opendous/Upconverter1v3/README.md

# Upconverter1v3
Upconverter 125MHz v1.3 - Passive Upconverter Hardware Design for SDR

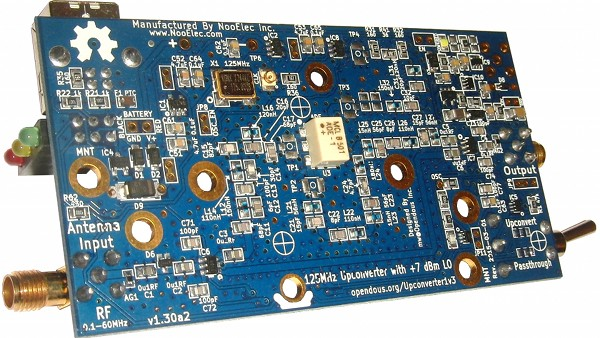
[picture p1: Upconverter-125MHz-ADE_Picture-Small.jpg]
Upconverter1v3 Picture


Converts signals in the [MF](http://en.wikipedia.org/wiki/Medium_frequency) and [HF](http://en.wikipedia.org/wiki/High_frequency) Bands (0.1MHz to 60MHz) to signals in the [VHF](https://en.wikipedia.org/wiki/Very_high_frequency) Band (125.5MHz to 175MHz). Intended for use in receiver applications with projects like [RTL-SDR](http://sdr.osmocom.org/trac/wiki/rtl-sdr). 

Available from [NooElec](http://www.nooelec.com/store/ham-it-up.html) or [eBay](http://www.ebay.com/sch/i.html?_from=R40&_nkw=Ham+It+Up+Upconverter+v1.3&_sacat=0).

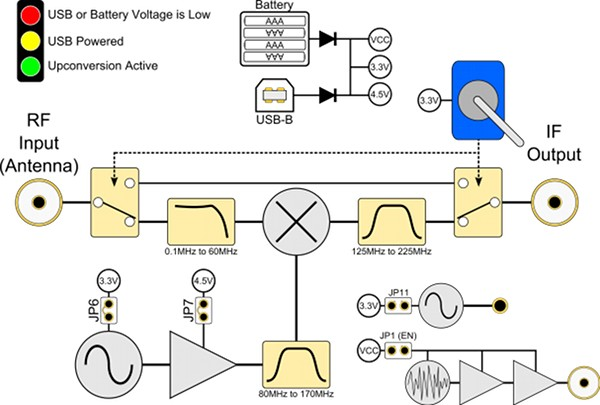
[picture p2: Upconverter_Diagram-Small.jpg]
Upconverter1v3 Diagram Diagram
