opendous/Upconverter1v3/GERBERS/readme.txt

File Format: Gerber RS-274-X
Plot Origin: Absolute

	Upconverter-125MHz-ADE-F_Paste.gtp	: Top/Front Layer Solder Paste Stencil

	Upconverter-125MHz-ADE-F_SilkS.gto	: Top/Front Layer White Silkscreen
	Upconverter-125MHz-ADE-F_Mask.gts	: Top/Front Layer Green Solder Mask
	Upconverter-125MHz-ADE-Front.gtl	: Top/Front Copper Layer
	Upconverter-125MHz-ADE-Back.gbl		: Bottom/Back Copper Layer
	Upconverter-125MHz-ADE-B_Mask.gbs	: Bottom/Back Layer Green Solder Mask

	Upconverter-125MHz-ADE-Edge_Cuts.gbr	: PCB Edge Outline

Drill File: Upconverter-125MHz-ADE.drl
	Excellon
	Units: Inches
	M.N (Precision) -> 2.4
	Mode (Drill Origin) : Absolute
	Zeros Format: Suppress Leading Zeros
	Type : ASCII
	Drill Holes (Pads and Vias): 590
	Notes:	- No axis mirroring
		- Standard Vias Only
		- All holes are plated
