opendous/Upconverter1v3/GERBERS/Upconverter-125MHz-ADE_PCB_Preview.jpg

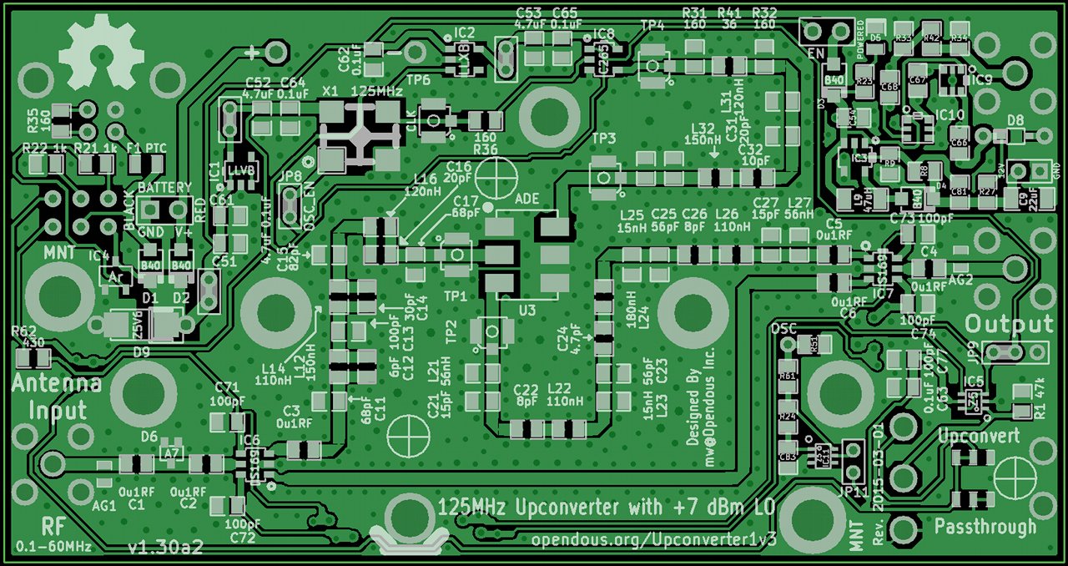
GERBERS/Upconverter-125MHz-ADE_PCB_Preview.jpg
