opendous/Upconverter1v3/Upconverter-125MHz-ADE_Layout.jpg

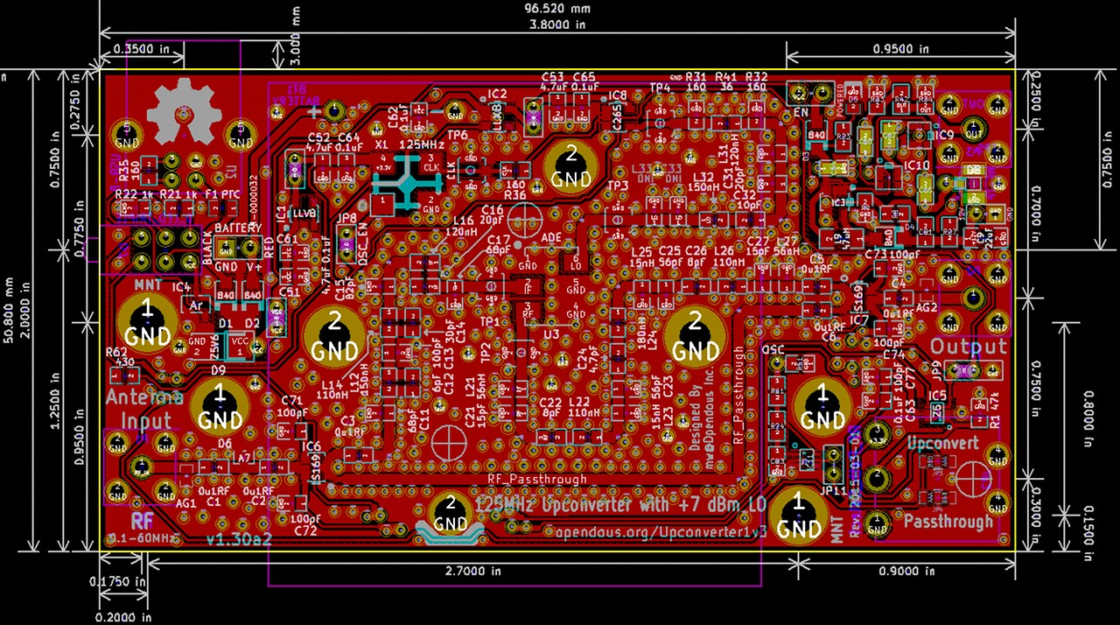
Upconverter-125MHz-ADE_Layout.jpg
