opendous/Upconverter1v3/Upconverter-125MHz-ADE_Schematic.pdf

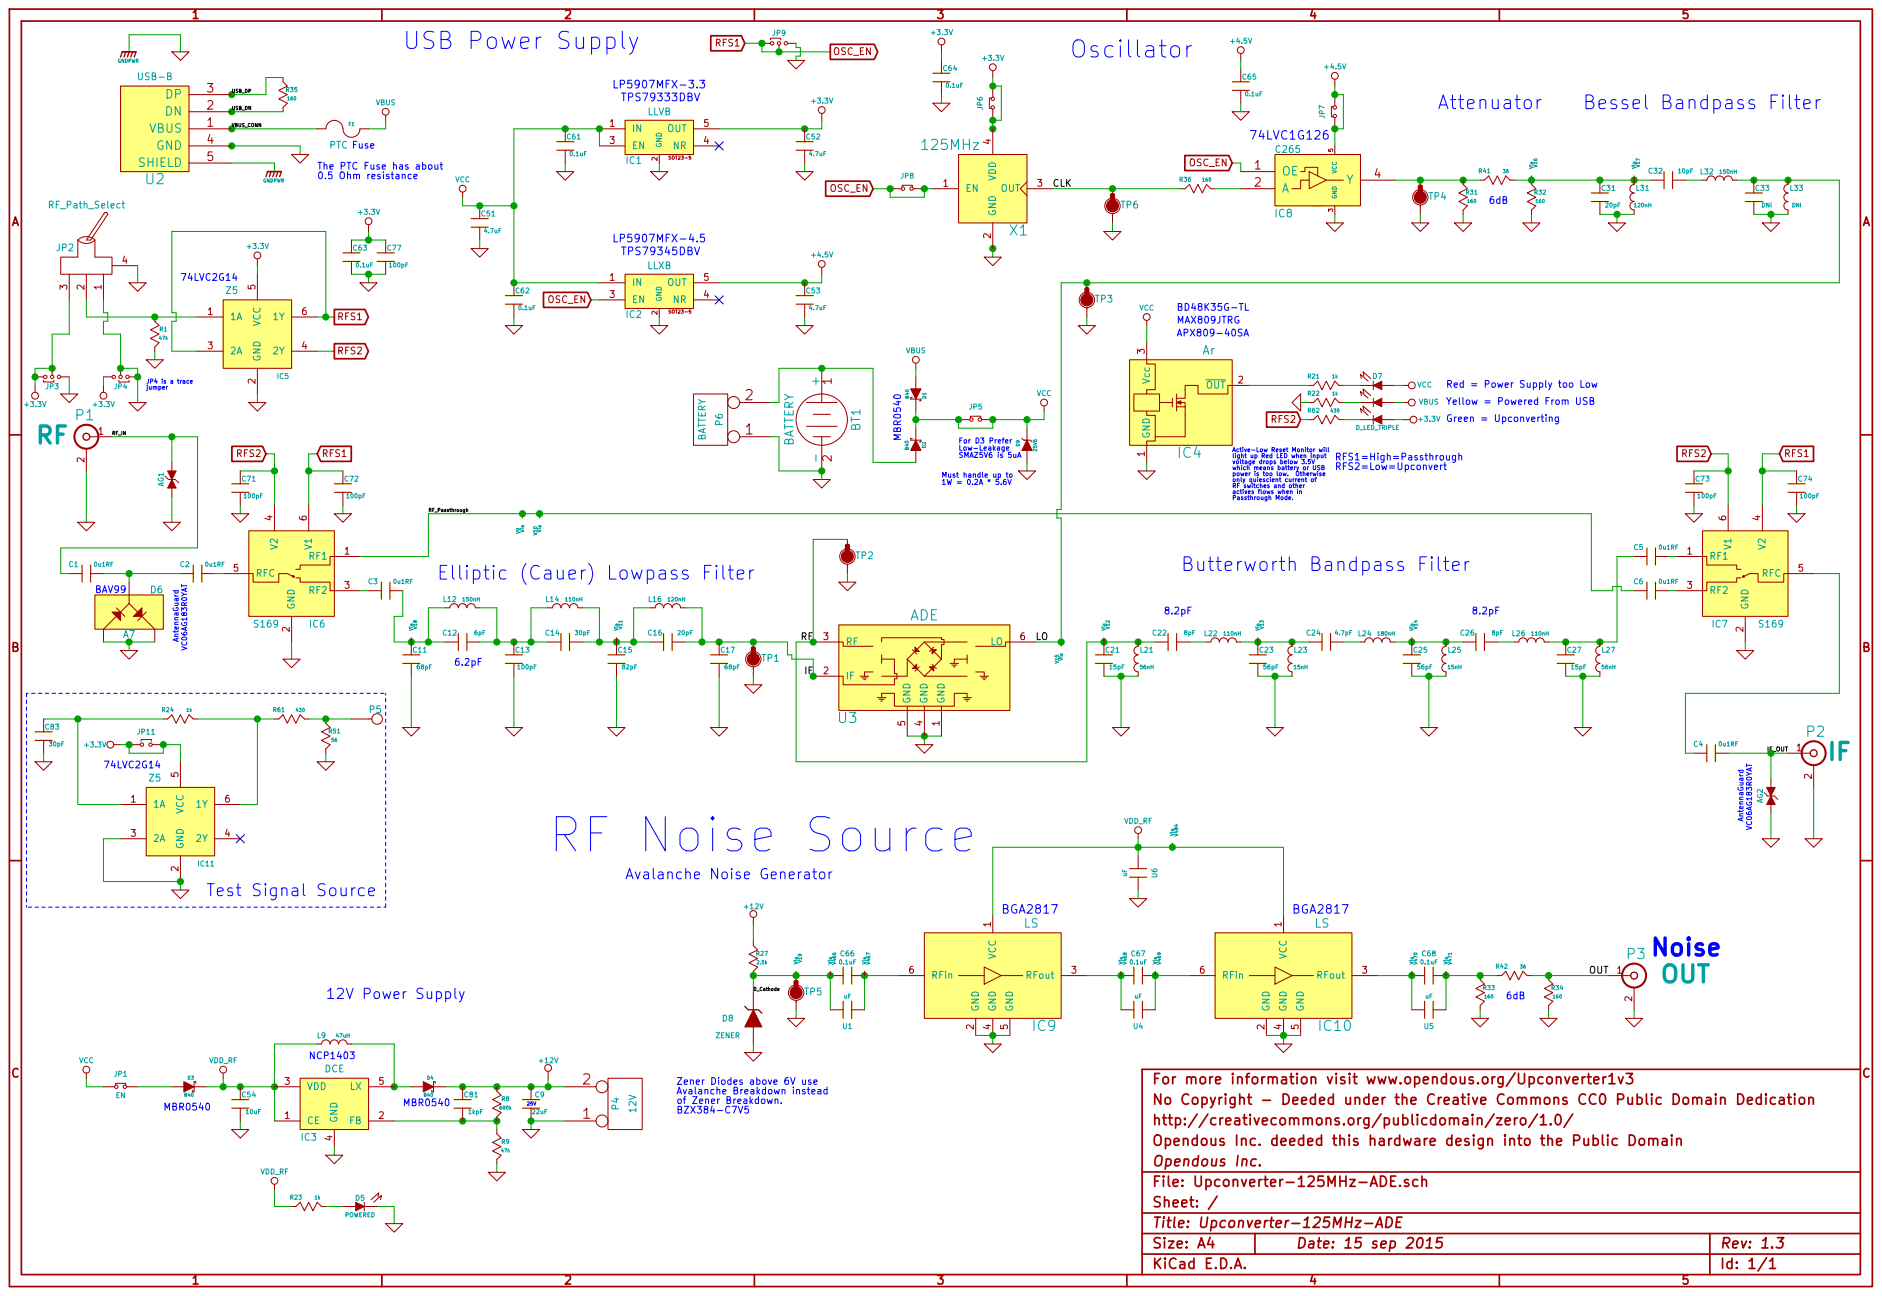
[picture p5: page 1]

Bessel Bandpass Filter RF

Yellow = Powered From USB Green = Upconverting

Active-Low Reset Monitor will
light up Red LED when input voltage drops below 3.5V which means battery or USB

power is too low. Otherwise

For more information visit www.opendous.org/Upconverter1v3
No Copyright - Deeded under the Creative Commons CC0 Public Domain Dedication
http://creativecommons.org/publicdomain/zero/1.0/
Opendous Inc. deeded this hardware design into the Public Domain
Opendous Inc.
File: Upconverter-125MHz-ADE.sch
Sheet: /
Title: Upconverter-125MHz-ADE
KiCad E.D.A.
