opendous/Upconverter1v3/Upconverter-125MHz-ADE.kicad_pcb

## KiCad design Upconverter-125MHz-ADE.kicad_pcb (2015-09-15)

Schematic: Upconverter-125MHz-ADE.sch

Parts:
AG1, AG2: ESD; 0603
BT1: BATTERY; BatteryHolder_2481_4AAA
C1, C2, C3, C4, C5, C6: 0u1RF; 0805
C9: 22uF; 1206
C11, C17: 68pF; 0805
C12: 6pF; 0805
C13, C71, C72, C73, C74, C77: 100pF; 0805
C14, C83: 30pF; 0805
C15: 82pF; 0805
C16, C31: 20pF; 0805
C21, C27: 15pF; 0805
C22, C26: 8pF; 0805
C23, C25: 56pF; 0805
C24: 4.7pF; 0805
C32: 10pF; 0805
C33: DNI; 0805
C51, C52, C53: 4.7uF; 0805
C54: 10uF; 0805
C61, C62, C63, C64, C65, C66, C67, C68: 0.1uF; 0805
C81: 1kpF; 0805
D1, D2, D3, D4: B40; SOD123
D5: POWERED; 0805
D6: A7; SC70-3_SOT-323
D7: D_LED_TRIPLE; 564-0x00_Triple_LED
D8: ZENER; SOD-323
D9: Z5V6; SMA_DO214A_Diode
F1: PTC; 0805
IC1: LLVB; SOT23-5
IC2: LLXB; SOT23-5
IC3: DCE; SOT23-5
IC4: Ar; SOT23-3
IC5: Z5; SC70-6
IC6, IC7: S169; SOT23-6
IC8: C265; SOT23-5
IC9, IC10: LS; SOT363_NXP
IC11: Z5; 000_SC70-6
JP1: EN; SIL-2
JP2: RF_Path_Select; MTS-1x2-C3
JP3, JP4: JUMPER-3; 0603_Jumper
JP5, JP6, JP7: JUMPER-2-NON; SIL-2POS-2mm
JP8: OSC_EN; SIL-2POS-2mm
JP9: JUMPER-3; SIL-3POS-2mm
JP11: JUMPER-2; SIL-2POS-2mm
L9: 47uH; 1206
L12, L32: 150nH; 0805
L14, L22, L26: 110nH; 0805
L16, L31: 120nH; 0805
L21, L27: 56nH; 0805
L23, L25: 15nH; 0805
L24: 180nH; 0805
L33: DNI; 0805
Logo1: Logo; OSHW_Logo
P1: RF; SMA_TH_RA
P2: IF; SMA_TH_RA
P3: OUT; SMA_TH_RA
P4: 12V; SIL-2POS-2mm
P5: OSC; 1Pin_32mil_VIA
P6: BATTERY; SIL-2
R1, R9: 47k; 0805
R8: 680k; 0805
R21, R22, R23, R24: 1k; 0805
R27: 2.5k; 0805
R31, R32, R33, R34, R35, R36: 160; 0805
R41, R42: 36; 0805
R51: 56; 0805
R61, R62: 430; 0805
TP1, TP2, TP3, TP4, TP5: RF-TP; UMCC_RF_PCB_RCPTCL
TP6: CLK; UMCC_RF_PCB_RCPTCL
U1, U4, U5, U6: uF; 0805
U2: USB-B; CONN_USB_B
U3: ADE; MiniCircuits_PL-052
V1, V2, V3, V4, V5, V6, V7, V8, V19, V20, V21, V22, V23, V24, V25, V26, V27, V28, V29, V30, V31, V32, V33, V34, V35, V36, V37, V38, V39, V40, V41, V42, V43, V44, V45, V46, V47, V48, V49, V50, V51, V52, V53, V54, V55, V56, V57, V58, V59, V60, V61, V62, V63, V64, V65, V66, V67, V68, V69, V70, V71, V72, V73, V74, V75, V76, V77, V78, V79, V80, V81, V82, V83, V84, V85, V86, V87, V88, V89, V90, V91, V92, V93, V94, V95, V96, V97, V98, V99, V100, V101, V102, V103, V104, V105, V106, V107, V108, V109, V110, V111, V112, V113, V114, V115, V116, V117, V118, V119, V120, V121, V122, V123, V124, V125, V126, V127, V128, V129, V130, V131, V132, V133, V134, V135, V136, V137, V138, V139, V140, V141, V142, V143, V144, V145, V146, V147, V148, V149, V150, V151, V152, V153, V154, V155, V156, V157, V158, V159, V160, V161, V162, V163, V164, V165, V166, V167, V168, V169, V170, V171, V172, V173, V174, V175, V176, V177, V178, V179, V180, V181, V182, V183, V184, V185, V186, V187, V188, V189, V190, V191, V192, V193, V194, V195, V196, V197, V198, V199, V200, V201, V202, V203, V204, V205, V206, V207, V208, V209, V210, V211, V212, V213, V214, V215, V216, V217, V218, V219, V220, V221, V222, V223, V224, V225, V226, V227, V228, V229, V230, V231, V232, V233, V234, V235, V236, V237, V238, V239, V240, V241, V242, V243, V244, V245, V246, V247, V248, V249, V250, V253, V254, V257, V258, V259, V260, V261, V262, V263, V264, V265, V266, V267, V268, V269, V270, V271, V272, V273, V274, V275, V276, V277, V278, V279, V280, V281, V282, V283, V284, V285, V286, V287, V288, V289, V290, V291, V292, V293, V294, V295, V296, V297, V298, V299, V300, V301, V302, V303, V304, V305, V306, V307, V308, V309, V310, V311, V312, V313, V314, V315, V316, V317, V318, V319, V320, V321, V322, V323, V324, V325, V326, V327, V328, V329, V330, V331, V332, V333, V334, V335, V336, V337, V338, V339, V340, V341, V342, V343, V344, V345, V346, V347, V348, V349, V350, V351, V352, V353, V354, V355, V356, V357, V358, V359, V360, V361, V362, V363, V364, V365, V366, V367, V368, V369, V370, V371, V372, V373, V374, V375, V376, V377, V458, V459, V460, V461, V462, V463, V464, V465, V466, V467, V468, V469, V470, V471, V472, V473, V474, V475, V476, V477, V478, V479, V480, V481, V482, V483, V484, V485, V493, V494, V497, V498, V513, V514, V515, V516, V517, V518, V519, V520, V521, V522, V523, V524: VIA; 1Pin_20mil_VIA
V9, V10, V11, V12, V13, V14, V15, V16, V17, V18: VIA; RF_Mitered_Corner_44mil
V251, V252, V255, V256, V378, V379, V380, V381, V382, V383, V384, V385, V386, V387, V388, V389, V390, V391, V392, V393, V394, V395, V396, V397, V398, V399, V400, V401, V402, V403, V404, V405, V406, V407, V408, V409, V410, V411, V412, V413, V414, V415, V416, V417, V418, V419, V420, V421, V422, V423, V424, V425, V426, V427, V428, V429, V430, V431, V432, V433, V434, V435, V436, V437, V438, V439, V440, V441, V442, V443, V444, V445, V446, V447, V448, V449, V450, V451, V452, V453, V454, V455, V456, V457, V486, V487, V488, V489, V490, V491, V492, V495, V496, V499, V500, V525, V526, V527, V528, V529, V530, V531, V532, V533, V534, V535, V536, V537, V538, V539, V540: VIA; 1Pin_25mil_VIA
V501, V502, V503, V504, V505, V506, V507, V508, V509, V510, V511, V512: VIA; 1Pin_32mil_VIA
X1: 125MHz; Crystal_7x5mm

Connections:
+3.3V: C52.1 (A), C63.1 (A), C64.1 (A), C77.1 (A), D7.6, IC1.5 (OUT), IC5.5 (VCC), IC11.5 (VCC), JP2.3 (B), JP3.2, JP3.3, JP4.1, JP6.1, JP6.2, JP11.1, JP11.2, V253.1, V254.1, V255.1, V256.1, X1.4 (VDD)
+4.5V: C53.1 (A), C65.1 (A), IC2.5 (OUT), IC8.5, JP7.1, JP7.2
+12V: C9.1 (A), C81.1 (A), D4.1, P4.2 (PM), R8.2 (B), R27.2 (B)
/CLK: R36.2 (B), TP6.1 (RF), X1.3 (OUT)
/D_Cathode: C66.1 (A), D8.1, R27.1 (A), TP5.1 (RF), U1.1 (A), V19.1, V466.1
/IF: C16.2 (B), C17.1 (A), L16.1 (A), TP1.1 (RF), U3.2 (IF)
/IF_OUT: AG2.1, C4.2 (B), P2.1 (In)
/LO: C33.1 (A), L32.1 (A), L33.1 (A), TP3.1 (RF), U3.6 (LO), V15.1
/OUT: P3.1 (In), R34.2 (B), R42.1 (A)
/RF: C21.1 (A), C22.1 (A), L21.1 (A), TP2.1 (RF), U3.3 (RF), V12.1
/RF_IN: AG1.1, C1.1 (A), P1.1 (In)
/RF_Passthrough: C6.1 (A), IC6.1 (RF1), V9.1, V10.1
/USB_DN: R35.1 (A), U2.2 (DN)
/USB_DP: R35.2 (B), U2.3 (DP)
/VBUS_CONN: F1.2 (B), U2.1 (VBUS)
GND: AG1.2, AG2.2, BT1.2 (-), C9.2 (B), C11.2 (B), C13.2 (B), C15.2 (B), C17.2 (B), C21.2 (B), C23.2 (B), C25.2 (B), C27.2 (B), C31.2 (B), C33.2 (B), C51.2 (B), C52.2 (B), C53.2 (B), C54.2 (B), C61.2 (B), C62.2 (B), C63.2 (B), C64.2 (B), C65.2 (B), C71.2 (B), C72.2 (B), C73.2 (B), C74.2 (B), C77.2 (B), C83.2 (B), D5.1 (K), D6.1, D6.2, D8.2, D9.2, IC1.2 (GND), IC2.2 (GND), IC3.4, IC4.1 (GND), IC5.2 (GND), IC6.2 (GND), IC7.2 (GND), IC8.3, IC9.2 (GND), IC9.4 (GND), IC9.5 (GND), IC10.2 (GND), IC10.4 (GND), IC10.5 (GND), IC11.2 (GND), IC11.3 (2A), JP2.1 (A), JP2.4 (GND), JP3.1, JP4.2, JP4.3, JP9.1, L21.2 (B), L23.2 (B), L25.2 (B), L27.2 (B), L31.2 (B), L33.2 (B), P1.2 (Ext), P2.2 (Ext), P3.2 (Ext), P4.1, P6.1, R1.1 (A), R9.1 (A), R22.2 (B), R31.1 (A), R32.1 (A), R33.1 (A), R34.1 (A), R51.1 (A), TP1.2 (GND), TP2.2 (GND), TP3.2 (GND), TP4.2 (GND), TP5.2 (GND), TP6.2 (GND), U2.4 (GND), U2.5 (SHIELD), U3.1 (GND), U3.4 (GND), U3.5 (GND), U6.1 (A), V1.1, V2.1, V3.1, V4.1, V5.1, V6.1, V7.1, V8.1, V20.1, V21.1, V22.1, V23.1, V24.1, V25.1, V26.1, V27.1, V28.1, V29.1, V30.1, V31.1, V32.1, V33.1, V34.1, V35.1, V36.1, V37.1, V38.1, V39.1, V40.1, V41.1, V42.1, V43.1, V44.1, V45.1, V46.1, V47.1, V48.1, V49.1, V50.1, V51.1, V52.1, V53.1, V54.1, V55.1, V56.1, V57.1, V58.1, V59.1, V60.1, V61.1, V62.1, V63.1, V64.1, V65.1, V66.1, V67.1, V68.1, V69.1, V70.1, V71.1, V72.1, V73.1, V74.1, V75.1, V76.1, V77.1, V78.1, V79.1, V80.1, V81.1, V82.1, V83.1, V84.1, V85.1, V86.1, V87.1, V88.1, V89.1, V90.1, V91.1, V92.1, V93.1, V94.1, V95.1, V96.1, V97.1, V98.1, V99.1, V100.1, V101.1, V102.1, V103.1, V104.1, V105.1, V106.1, V107.1, V108.1, V109.1, V110.1, V111.1, V112.1, V113.1, V114.1, V115.1, V116.1, V117.1, V118.1, V119.1, V120.1, V121.1, V122.1, V123.1, V124.1, V125.1, V126.1, V127.1, V128.1, V129.1, V130.1, V131.1, V132.1, V133.1, V134.1, V135.1, V136.1, V137.1, V138.1, V139.1, V140.1, V141.1, V142.1, V143.1, V144.1, V145.1, V146.1, V147.1, V148.1, V149.1, V150.1, V151.1, V152.1, V153.1, V154.1, V155.1, V156.1, V157.1, V158.1, V159.1, V160.1, V161.1, V162.1, V163.1, V164.1, V165.1, V166.1, V167.1, V168.1, V169.1, V170.1, V171.1, V172.1, V173.1, V174.1, V175.1, V176.1, V177.1, V178.1, V179.1, V180.1, V181.1, V182.1, V183.1, V184.1, V185.1, V186.1, V187.1, V188.1, V189.1, V190.1, V191.1, V192.1, V193.1, V194.1, V195.1, V196.1, V197.1, V198.1, V199.1, V200.1, V201.1, V202.1, V203.1, V204.1, V205.1, V206.1, V207.1, V208.1, V209.1, V210.1, V211.1, V212.1, V213.1, V214.1, V215.1, V216.1, V217.1, V218.1, V219.1, V220.1, V221.1, V222.1, V223.1, V224.1, V225.1, V226.1, V227.1, V228.1, V229.1, V230.1, V231.1, V232.1, V233.1, V234.1, V235.1, V236.1, V237.1, V238.1, V239.1, V240.1, V241.1, V242.1, V243.1, V244.1, V245.1, V246.1, V247.1, V248.1, V257.1, V258.1, V259.1, V260.1, V261.1, V262.1, V263.1, V264.1, V265.1, V266.1, V267.1, V268.1, V269.1, V270.1, V271.1, V272.1, V273.1, V274.1, V275.1, V276.1, V277.1, V278.1, V279.1, V280.1, V281.1, V282.1, V283.1, V284.1, V285.1, V286.1, V287.1, V288.1, V289.1, V290.1, V291.1, V292.1, V293.1, V294.1, V295.1, V296.1, V297.1, V298.1, V299.1, V300.1, V301.1, V302.1, V303.1, V304.1, V305.1, V306.1, V307.1, V308.1, V309.1, V310.1, V311.1, V312.1, V313.1, V314.1, V315.1, V316.1, V317.1, V318.1, V319.1, V320.1, V321.1, V322.1, V323.1, V324.1, V325.1, V326.1, V327.1, V328.1, V329.1, V330.1, V331.1, V332.1, V333.1, V334.1, V335.1, V336.1, V337.1, V338.1, V339.1, V340.1, V341.1, V342.1, V343.1, V344.1, V345.1, V346.1, V347.1, V348.1, V349.1, V350.1, V351.1, V352.1, V353.1, V354.1, V355.1, V356.1, V357.1, V358.1, V359.1, V360.1, V361.1, V362.1, V363.1, V364.1, V365.1, V366.1, V367.1, V368.1, V369.1, V370.1, V371.1, V372.1, V373.1, V374.1, V375.1, V376.1, V377.1, V378.1, V379.1, V380.1, V381.1, V382.1, V383.1, V384.1, V385.1, V386.1, V387.1, V388.1, V389.1, V390.1, V391.1, V392.1, V393.1, V394.1, V395.1, V396.1, V397.1, V398.1, V399.1, V400.1, V401.1, V402.1, V403.1, V404.1, V405.1, V406.1, V407.1, V408.1, V409.1, V410.1, V411.1, V412.1, V413.1, V414.1, V415.1, V416.1, V417.1, V418.1, V419.1, V420.1, V421.1, V422.1, V423.1, V424.1, V425.1, V426.1, V427.1, V428.1, V429.1, V430.1, V431.1, V432.1, V433.1, V434.1, V435.1, V436.1, V437.1, V438.1, V439.1, V440.1, V441.1, V442.1, V443.1, V444.1, V445.1, V446.1, V447.1, V448.1, V449.1, V450.1, V451.1, V452.1, V453.1, V454.1, V455.1, V456.1, V457.1, V458.1, V459.1, V460.1, V461.1, V462.1, V463.1, V464.1, V465.1, V472.1, V473.1, V474.1, V475.1, V476.1, V477.1, V478.1, V479.1, V480.1, V481.1, V482.1, V483.1, V485.1, V486.1, V487.1, V488.1, V489.1, V490.1, V491.1, V492.1, V501.1, V502.1, V503.1, V504.1, V505.1, V506.1, V507.1, V508.1, V509.1, V510.1, V511.1, V512.1, V513.1, V514.1, V515.1, V516.1, V517.1, V518.1, V519.1, V520.1, V521.1, V522.1, V523.1, V524.1, V525.1, V526.1, V527.1, V528.1, V529.1, V530.1, V531.1, V532.1, V533.1, V534.1, V535.1, V536.1, V537.1, V538.1, V539.1, V540.1, X1.2 (GND)
unnamed: D7.3, R22.1 (A)
unnamed: D7.1, R21.1 (A)
unnamed: IC4.2 (~OUT), R21.2 (B)
unnamed: IC8.2, R36.1 (A)
unnamed: C68.1 (A), IC10.3 (RFout), U5.1 (A), V470.1
unnamed: C67.2 (B), IC10.6 (RFin), U4.2 (B), V469.1
unnamed: C1.2 (B), C2.1 (A), D6.3
unnamed: D4.2, IC3.5, L9.1 (A)
unnamed: IC5.1 (1A), JP2.2 (C), R1.2 (B)
unnamed: D7.5, R62.1 (A)
unnamed: C5.1 (A), C27.1 (A), L26.1 (A), L27.1 (A)
unnamed: D3.2, JP1.1
unnamed: C3.2 (B), C11.1 (A), C12.1 (A), L12.2 (B), V18.1
unnamed: C81.2 (B), IC3.2, R8.1 (A), R9.2 (B)
unnamed: BT1.1 (+), D2.2, P6.2 (PM)
unnamed: C2.2 (B), IC6.5 (RFC)
unnamed: IC11.6 (1Y), R24.1 (A), R61.2 (B)
unnamed: C83.1 (A), IC11.1 (1A), R24.2 (B)
unnamed: P5.1, R51.2 (B), R61.1 (A)
unnamed: C66.2 (B), IC9.6 (RFin), U1.2 (B), V467.1
unnamed: C67.1 (A), IC9.3 (RFout), U4.1 (A), V468.1
unnamed: C68.2 (B), R33.2 (B), R42.2 (B), U5.2 (B), V471.1
unnamed: C26.2 (B), L26.2 (B)
unnamed: C32.2 (B), L32.2 (B)
unnamed: C24.2 (B), L24.2 (B)
unnamed: C22.2 (B), L22.2 (B)
unnamed: C5.2 (B), IC7.1 (RF1)
unnamed: D5.2 (A), R23.1 (A)
unnamed: C3.1 (A), IC6.3 (RF2)
unnamed: C6.2 (B), IC7.3 (RF2)
unnamed: C14.2 (B), C15.1 (A), C16.1 (A), L14.1 (A), L16.2 (B), V11.1
unnamed: C4.1 (A), IC7.5 (RFC)
unnamed: IC8.4, R31.2 (B), R41.2 (B), TP4.1 (RF)
unnamed: C31.1 (A), C32.1 (A), L31.1 (A), R32.2 (B), R41.1 (A), V16.1, V17.1
unnamed: C25.1 (A), C26.1 (A), L24.1 (A), L25.1 (A), V14.1
unnamed: C12.2 (B), C13.1 (A), C14.1 (A), L12.1 (A), L14.2 (B)
unnamed: C23.1 (A), C24.1 (A), L22.1 (A), L23.1 (A), V13.1
OSC_EN: C72.1 (A), C74.1 (A), IC2.3 (EN), IC5.3 (2A), IC5.6 (1Y), IC6.6 (V1), IC7.4 (V2), IC8.1, JP8.1, JP8.2, JP9.2, JP9.3, V249.1, V250.1, V251.1, V252.1, V497.1, V498.1, V499.1, V500.1, X1.1 (EN)
RFS2: C71.1 (A), C73.1 (A), IC5.4 (2Y), IC6.4 (V2), IC7.6 (V1), R62.2 (B), V493.1, V494.1, V495.1, V496.1
VBUS: D1.2, D7.4, F1.1 (A)
VCC: C51.1 (A), C61.1 (A), C62.1 (A), D1.1, D2.1, D7.2, D9.1, IC1.1 (IN), IC1.3 (EN), IC2.1 (IN), IC4.3 (Vcc), JP1.2, JP5.1, JP5.2
VDD_RF: C54.1 (A), D3.1, IC3.1, IC3.3, IC9.1 (VCC), IC10.1 (VCC), L9.2 (B), R23.2 (B), U6.2 (B), V484.1

Notes on the sheet:
Attenuator
6dB
74LVC1G126
74LVC2G14
RF Noise Source
Noise
Bessel Bandpass Filter
USB Power Supply
Oscillator
TPS79333DBV
Elliptic (Cauer) Lowpass Filter
Butterworth Bandpass Filter
Fuse
12V Power Supply
Zener Diodes above 6V use Avalanche Breakdown instead of Zener Breakdown. BZX384-C7V5
The PTC Fuse has about 0.5 Ohm resistance
Avalanche Noise Generator
25V
NCP1403
LP5907MFX-3.3
MBR0540
VC06AG183R0YAT
AntennaGuard
TPS79345DBV
LP5907MFX-4.5
RFS1=High=Passthrough RFS2=Low=Upconvert
Active-Low Reset Monitor will light up Red LED when input voltage drops below 3.5V which means battery or USB power is too low. Otherwise only quiescient current of RF switches and other actives flows when in Passthrough Mode.
BD48K35G-TL
APX809-40SA
MAX809JTRG
JP4 is a trace jumper
Red = Power Supply too Low
Yellow = Powered From USB
Green = Upconverting
8.2pF
6.2pF
For D3 Prefer Low-Leakage SMAZ5V6 is 5uA
Must handle up to 1W = 0.2A * 5.6V
BAV99
BGA2817
Test Signal Source

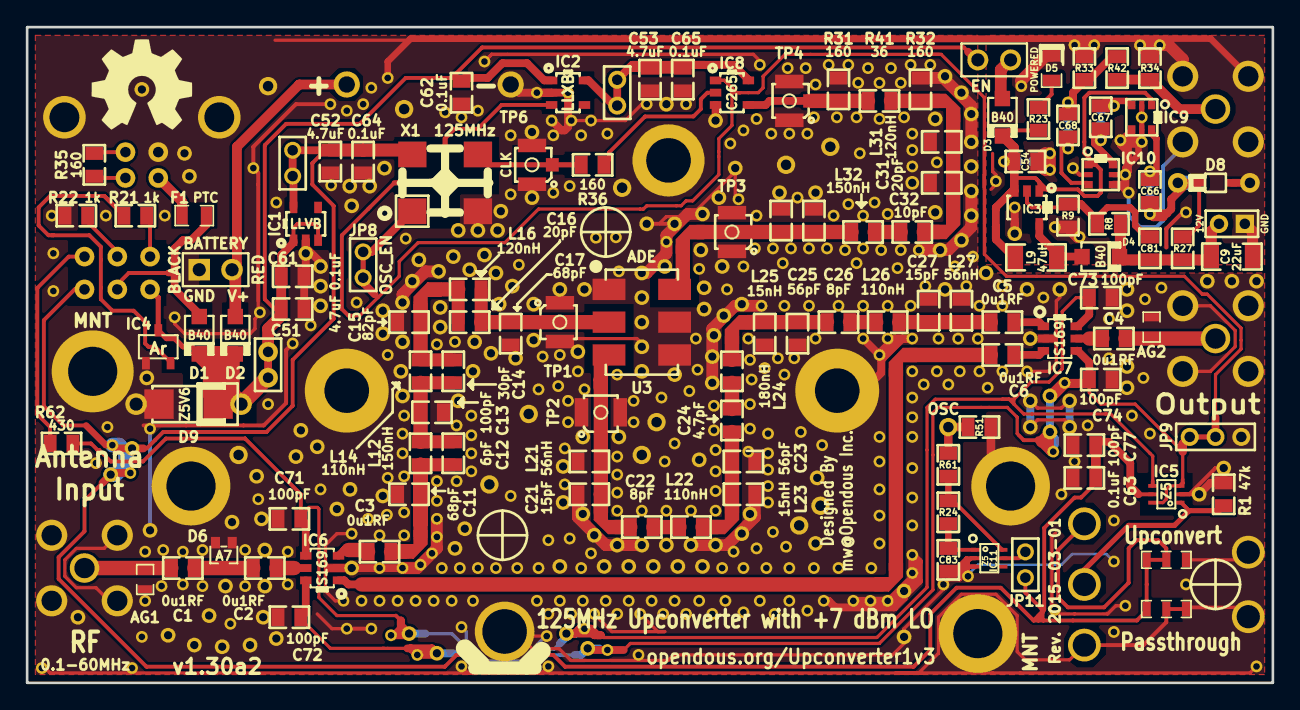
[picture p6: board Upconverter-125MHz-ADE.kicad_pcb from above]

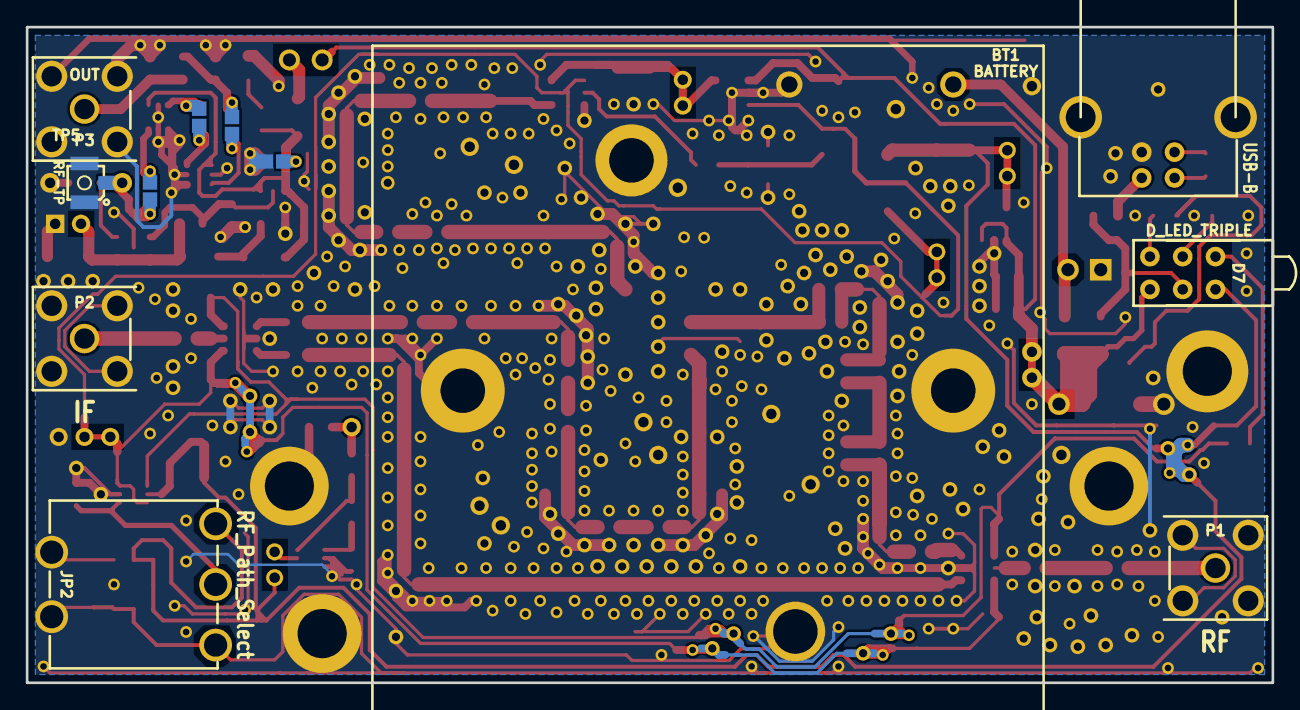
[picture p7: board Upconverter-125MHz-ADE.kicad_pcb from below]

Board: 2 copper layers, 96.5 x 50.8 mm, 670 parts (12 on the bottom side), 58 nets.
