opendous/Upconverter1v3/Upconverter-125MHz-ADE_Assembly_Instructions.jpg

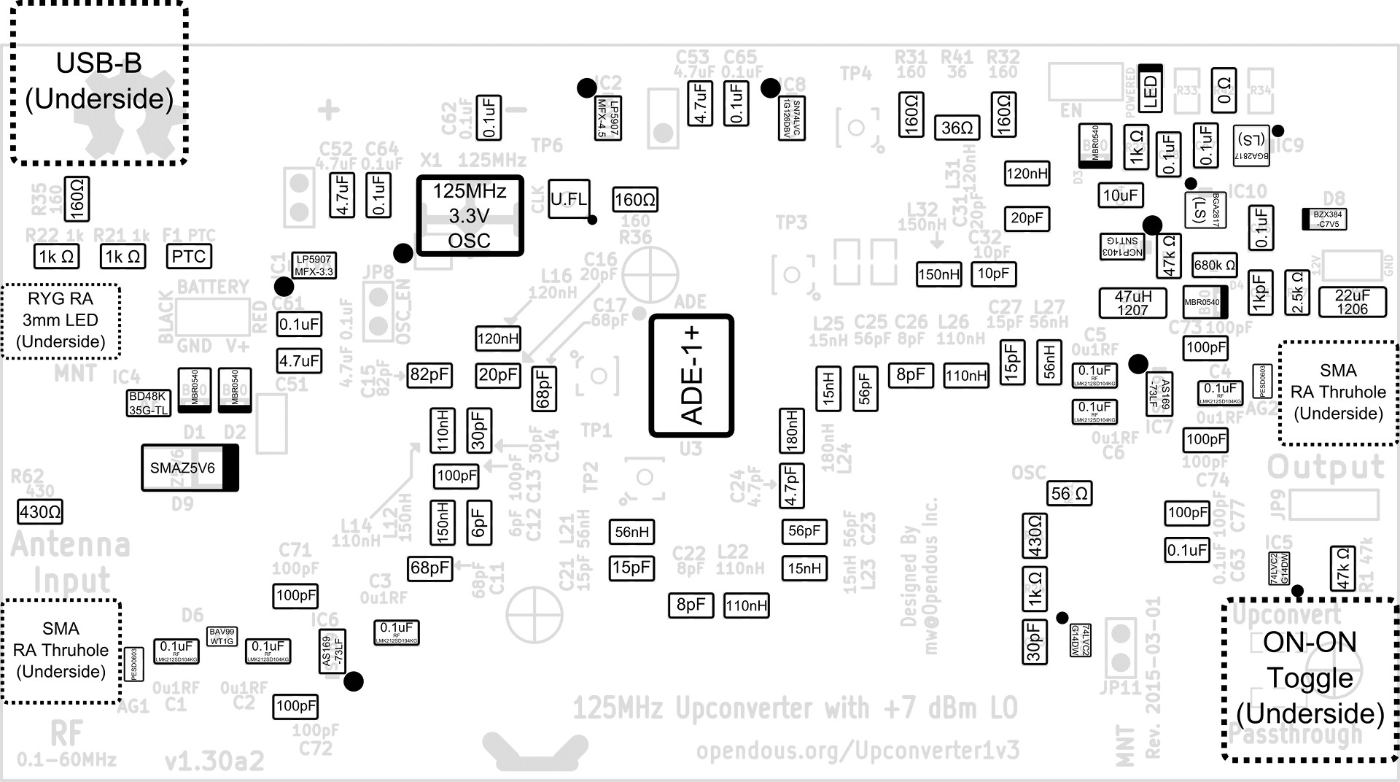
Upconverter-125MHz-ADE_Assembly_Instructions.jpg
