opendous/Upconverter1v3/(threads)

Thread 1 (2020-10-09):

Missing Library

Nennala, 2020-10-09:
Hi,

I know this project have 5 years since the last update, but when I try to open it, I have a lot of libraries missing
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

Is it Kicad 4 libraries ? Or did you use other library and can give me a link to get them as I could import correctly all the components, footprint and stuff opening your projet ?

Thanks in advance, regards.

Nennala.

moschik-it, 2023-02-25:
https://code.google.com/archive/p/opendous/downloads
